johnpeck/boxcom/implement/boards/usb/reva/layout/printable/prettypic.png

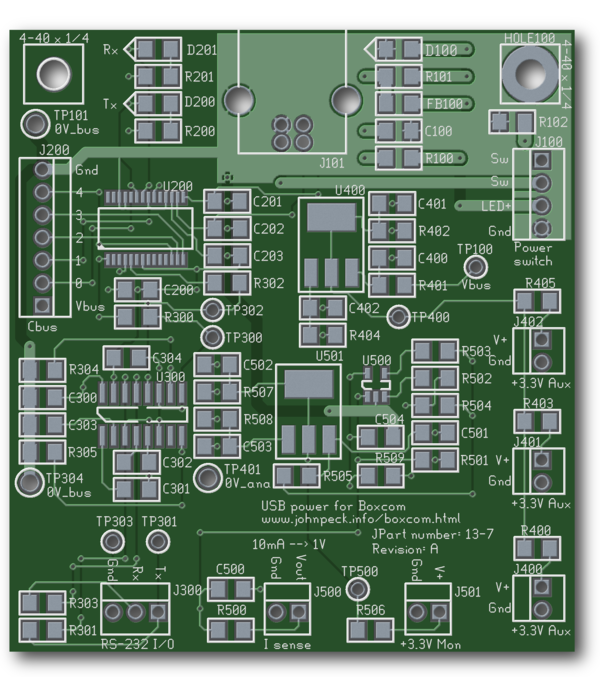
implement/boards/usb/reva/layout/printable/prettypic.png
