johnpeck/boxcom/README

Boxcom -- ASCII communication for the AVR Butterfly
