johnpeck/boxcom/implement/chassis/revb/sticker/output/sticker.pdf

# Boxcom

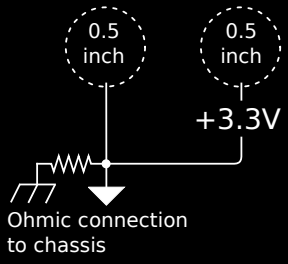
[picture p2: figure]
0.5 inch; Ohmic connection to chassis
