johnpeck/boxcom/implement/simulations/lt3080_sensing.pdf

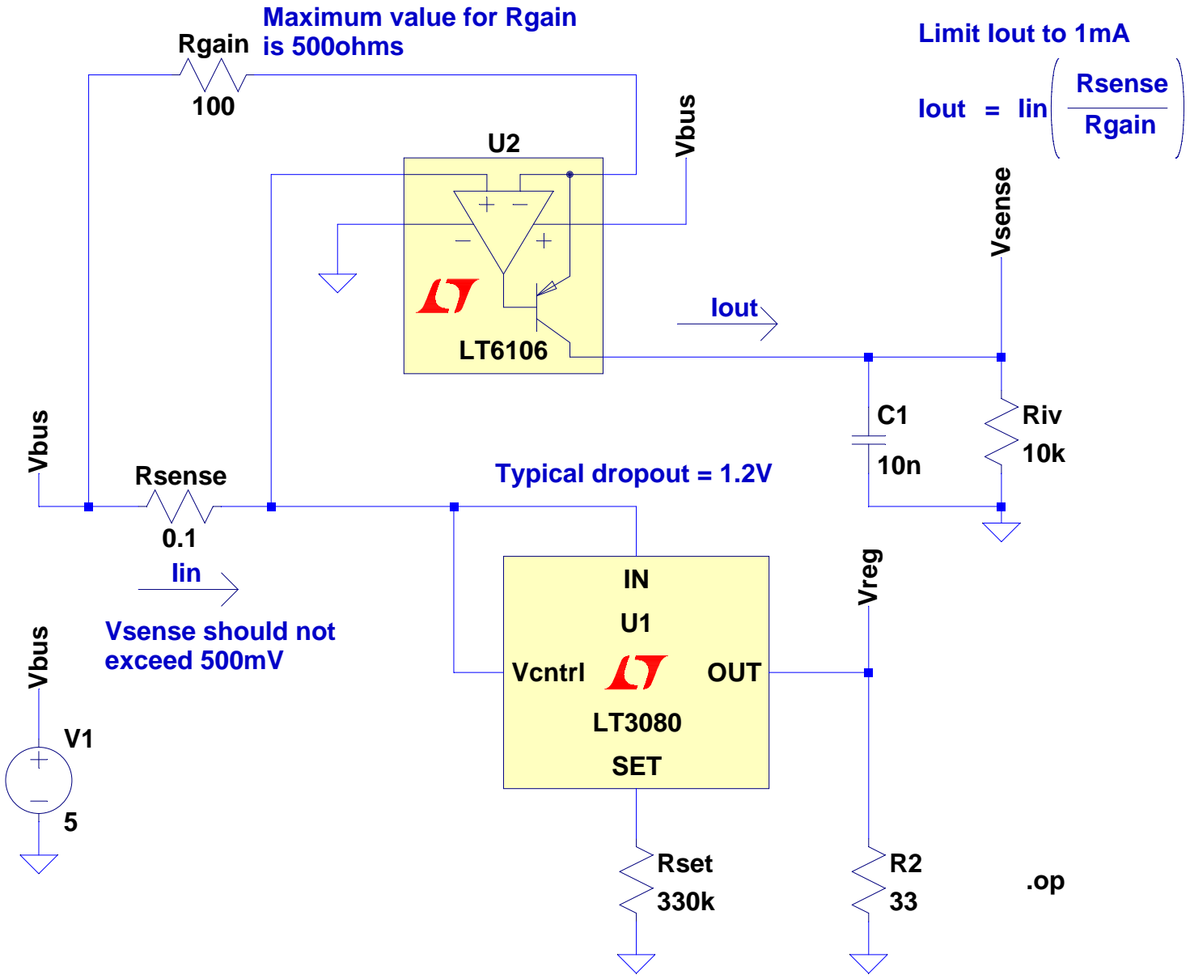
[picture p3: figure]
SET; Vcntrl; OUT; Rset 330k; Rsense; Rgain; Riv 10k; C1 10n Vreg; Vsense; Vbus Vbus; Vbus; Iin; Iout; Rsense Rgain =; Maximum value for Rgain; is 500ohms; Limit Iout to 1mA; Typical dropout = 1.2V; Vsense should not exceed 500mV

uments and Settings\jpeck.THINKSRS\My Documents\projects\boxcom\implement\simulations\lt3080_sensi
