johnpeck/boxcom/implement/howto/commands/idn.tex

\asciicmd{*IDN?}{
    \index{user_cmds_index}{*IDN?}
    \label{cmd:idn}

    \textbf{Name:} \texttt{*IDN?} -- Print the instrument identification string.\\
    \textbf{Description:} No description.
}
