johnpeck/boxcom/implement/howto/commands/curslp.tex

\asciicmd{\$curslp\{i\}}{
    \index{internal_cmds_index}{\$curslp}
    \label{cmd:curslp}

    \textbf{Name:} \texttt{\$curslp} -- Set the current output slope calibration 
                                        factor.\\
    \textbf{Description:} No description.

}
