johnpeck/boxcom/implement/howto/howto.pdf

## boxcom howto

May 11, 2013

## Contents

1 USB board | 3
2 Butterfly board | 7
3 Firmware | 8
Alphabetical command index | 15
Internal command index | 16

2

### 1 USB board

## 1 USB board

### 1.1 The front panel switch

Figure 1 shows how the front panel power switch should be wired.

+ -

Switch

Switch

LED+

LED-

Eswitch panel
rocker switch
Part 21-1

5-inch lengths
of 24-gauge wire

Cover each solder
lug with 1/2-inch
of 1/8-inch heat
shrink (16-22)

Bind wires together
with two 1/4-inch pieces
of 1/8-inch heat shrink
(16-22)

Figure 1: Panel switch wiring

Boxcom howto | 3 | May 11, 2013

1 USB board | 1.2 Board checkout

### 1.2 Board checkout

### 1.2.1 Voltage rails

Use table 1 to keep track of voltage rails.

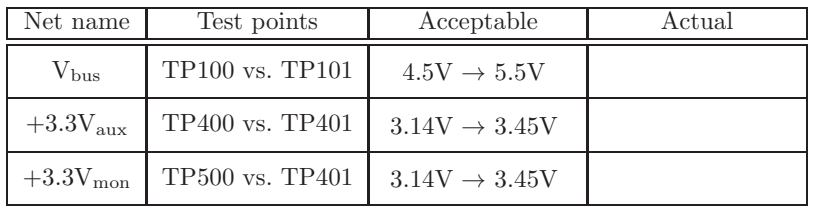
[picture p4: figure]
Net name; Test points; Acceptable; Actual; Vbus; +3.3Vaux; +3.3Vmon

Table 1: Voltage rail checkout table for the USB board.

### 1.2.2 Current monitor

The current monitor output at J500 will have a fixed DC output, since the voltage regulator following it always draws at least 1mA. As illustrated in figure 2, the slope set in hardware should give ∆Vout = 1V for each additional 10mA of current draw from J501. Since the voltage output from J501 is controlled at 3.3V, a test load of 3.3kΩ should increase the voltage at J500 by 100mV.

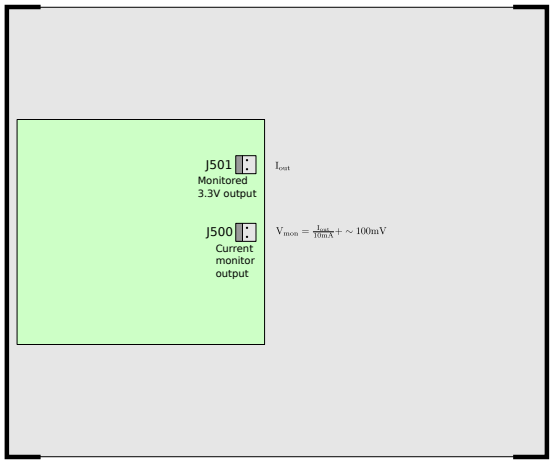
[picture p5: figure]
Current monitor output; Monitored 3.3V output

Figure 2: The output connectors used during the current monitor test.

Load applied to J501 | Acceptable Vout at J500 | Measured Vout at J500

Table 2: Passing voltage measurements for the current monitor test.

Boxcom howto | 4 | May 11, 2013

1 USB board | 1.2 Board checkout

### 1.2.3 Serial loopback

The serial loopback test is a basic test of the USB/serial interface and the RS-232 transceiver. Make the breakout cable shown in figure 3, then make connections to the board as shown in figure 4.

1 2 3 4 5

6 7 8 9

Chassis-mount DB-9
connector
Part number 14-16

3-pin mta100 plug
Part number 14-10

Use 24AWG stranded
wire for mta100

Figure 3: Wiring the DB9 breakout cable for the serial loopback test.

The serial loopback test script is:

boxcom/implement/data/scripts/tty loopback.py

...and the test should pass at the speed listed in table 3.

Minimum passing baud | Measured passing baud

Table 3: Passing baud measurement for the serial loopback test. The usb board should be able to reliably pass the loopback test for data flowing in both directions at the minimum baud.

Boxcom howto | 5 | May 11, 2013

1 USB board | 1.2 Board checkout

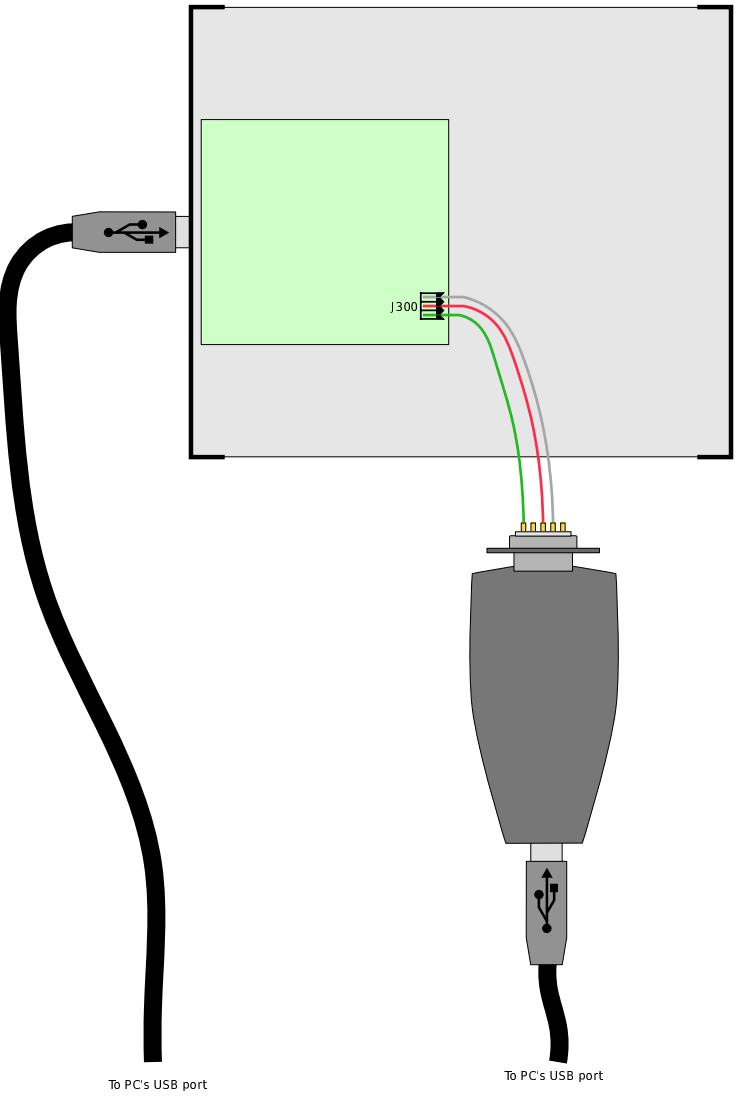
[picture p6: figure]

Figure 4: The setup for the serial loopback test.

Boxcom howto | 6 | May 11, 2013

### 2 Butterfly board

## 2 Butterfly board

### 2.1 Making connections

Figure 5 shows the connections that should be made to the Butterfly board.

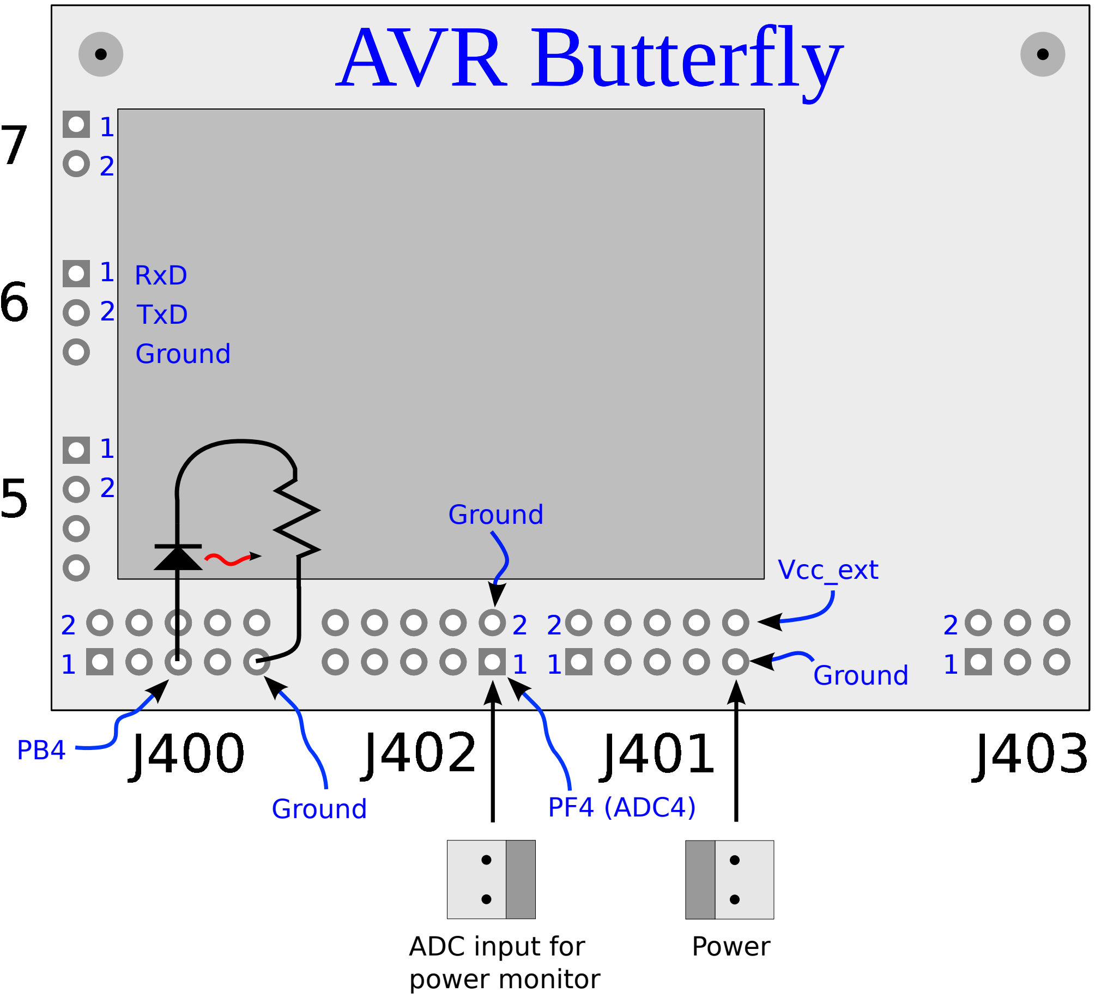
[picture p7: figure]
AVR Butterfly; ADC input for power monitor; Ground; PF4 (ADC4); Power; Vcc_ext; RxD TxD Ground

Figure 5: Connections to the AVR Butterfly

Figure 6 shows how the UART cable should be made.

6 inches

es
h h
shrin

(This side shown

ed

Figure 6: The UART cable connecting the Butterfly and USB boards.

Figure 7 shows how to make the power cable.

6 inches

es
h h
shrin

(This side shown

ed

Figure 7: The power cable connecting the Butterfly and the USB boards. The cable should run from J400 on the USB board to the power connector shown in figure 5.

Boxcom howto | 7 | May 11, 2013

### 3 Firmware

## 3 Firmware

### 3.1 Received character flow

Receiving remote commands begins with receiving characters. Reception of these characters triggers an interrupt service routine (ISR), which handles them according to the flow shown in figure 8. The first step in this flow is loading the characters into the receive buffer.

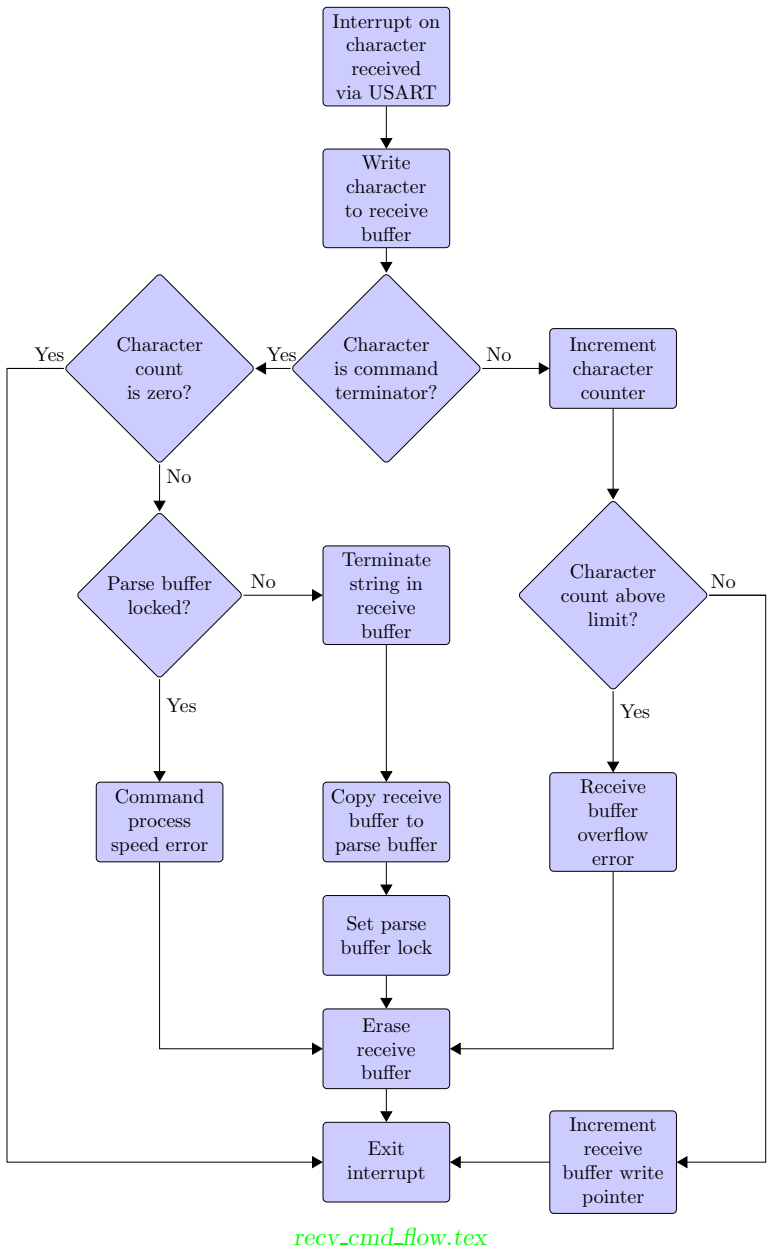
[picture p8: figure]
Interrupt on character received via USART; Write character to receive buffer; Character is command terminator?; Character count is zero?; Increment character counter; Parse buffer locked?; Terminate string in receive buffer; Copy receive buffer to parse buffer; Set parse buffer lock; Erase receive buffer; Character count above limit?; Receive buffer overflow error; Command process speed error; Exit interrupt; Increment receive buffer write pointer; Yes; recv cmd flow.tex

Figure 8: Program flow for processing characters received over the Butterfly’s USART. Sending a command terminator (carriage return) will always result in an empty receive buffer. This is a good way to make sure there’s no garbage in the buffer before writing to it.

Boxcom howto | 8 | May 11, 2013

3 Firmware | 3.1 Received character flow

Figure 9 illustrates the receive buffer loaded with a combined string. The buffer is accessed with a pointer to its beginning and a second pointing to the next index to be written. These pointers are members of the recv cmd state t type variable recv cmd state. This is just style – I like to try to organize variables used in a flow by making them members of their own structure. Naming conventions aside, it’s important to notice that there are no limitations on command or argument size imposed in this first step, provided that the total character count stays under the RECEIVE BUFFER SIZE limit.

## RECEIVE_BUFFER_SIZE

Buffer size set with #define

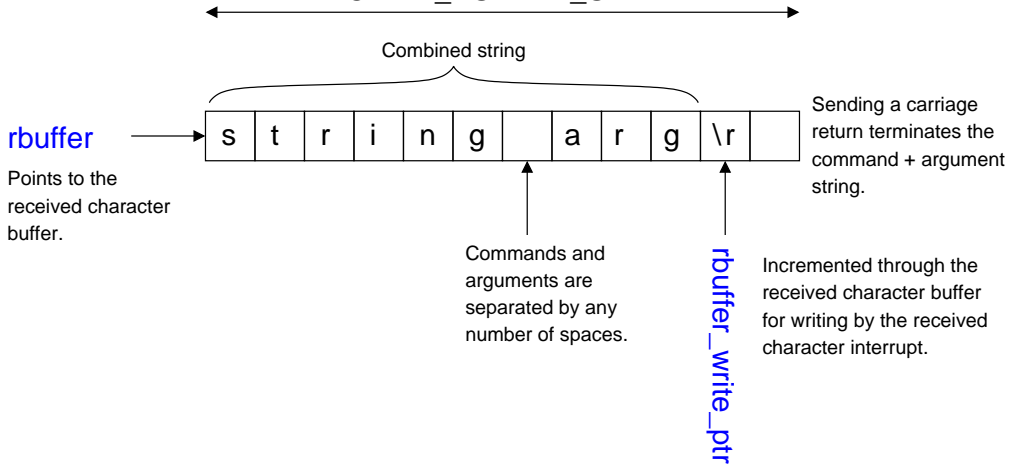
[picture p9: figure]
Commands and arguments are separated by any number of spaces.; Incremented through the received character buffer for writing by the received character interrupt.; Sending a carriage return terminates the command + argument string.; Points to the received character buffer.; rbuffer; rbuffer_write_ptr; Combined string

recbuffer.fig

Figure 9: The received character buffer and pointers used to fill it. There is no limit to the size of commands and their arguments, as long as the entire combined string and terminator fit inside RECEIVE BUFFER SIZE.

When a combined string in the receive buffer is finished with a carriage return, the string is copied over to a second buffer. I call this the parse buffer, since this is where the string will be searched for recognized commands and arguments. This buffer is locked until its contents can be processed to keep it from being clobbered by new combined strings. Sending commands faster than they can be processed will generate an error, and combined strings sent to a locked parse buffer will be dropped. The maximum command processing frequency will depend on the system clock and other system tasks. Not having larger parse or receive buffers is a limitation that puts this project at the hobby level. Extending these buffers to hold more than just one command would make the system more robust.

Boxcom howto | 9 | May 11, 2013

3 Firmware | 3.2 How remote commands are processed

### 3.2 How remote commands are processed

After combined strings are copied from the receive to the parse buffer, the system separates them into command and argument strings using the flow shown in figure 10. Commands in the parse buffer are then separated from their arguments with a string terminator inserted into the first space between the two. As illustrated in figure 11, pointers to the beginning of the parse buffer and the beginning of the argument will then reference two separate strings. The first of these two, the command string, is converted to lowercase and compared with those in the command definition array to look for a match.

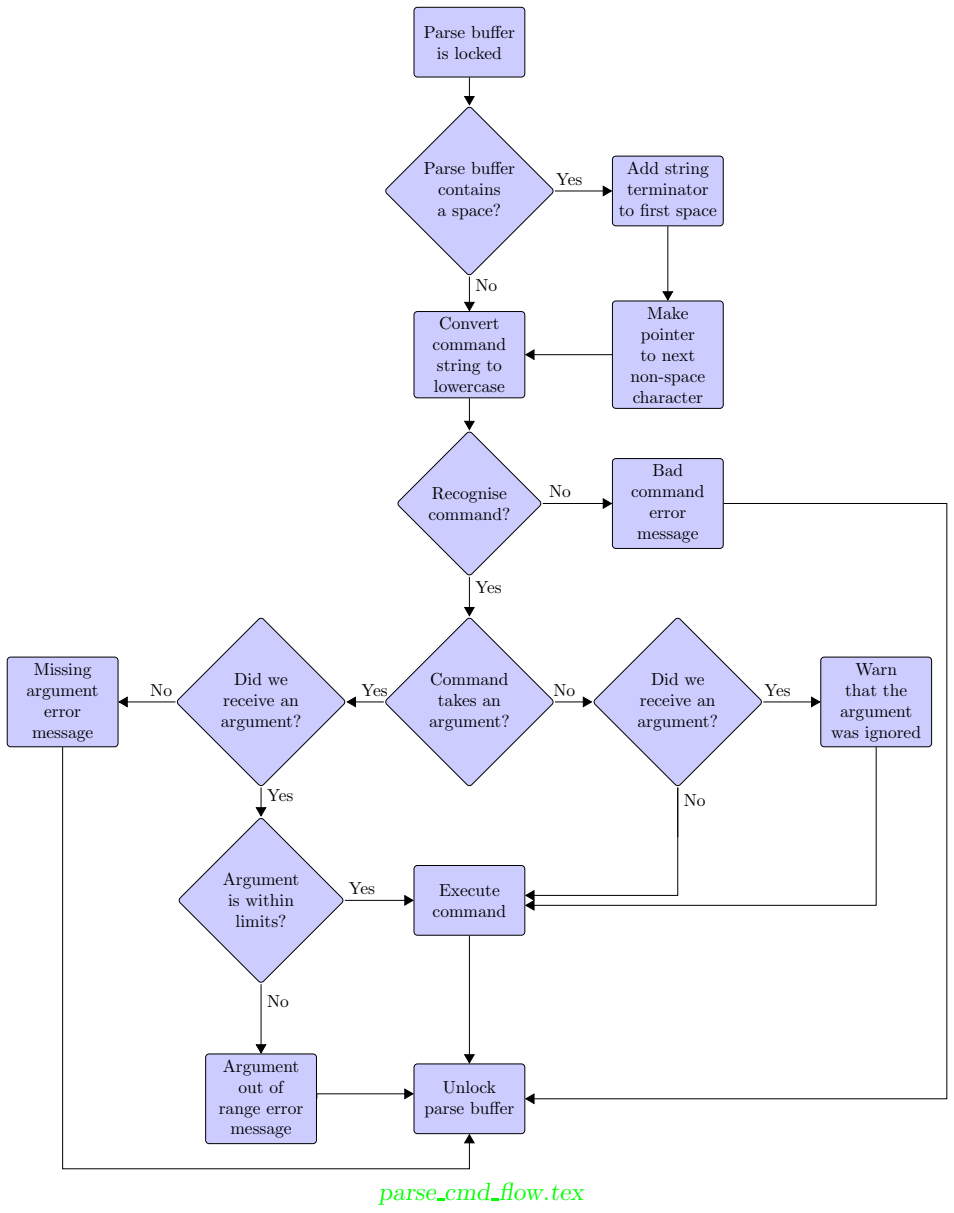
[picture p10: figure]
Parse buffer is locked; Parse buffer contains a space?; Add string terminator to first space; Convert command string to lowercase; Make pointer to next non-space character; Recognise command?; Bad command error message; Command takes an argument?; Did we receive an argument?; Warn that the argument was ignored; Missing argument error message; Argument is within limits?; Argument out of range error message; Execute command; Unlock parse buffer; Yes; parse cmd flow.tex

Figure 10: Program flow for processing fully-formed commands. This processing step happens in the main loop, so it will only run when the system isn’t busy doing something else. Notice that all incoming commands are converted to lowercase, so there’s no case sensitivity.

Boxcom howto | 10 | May 11, 2013

3 Firmware | 3.2 How remote commands are processed

### RECEIVE_BUFFER_SIZE

Same size as received character buffer

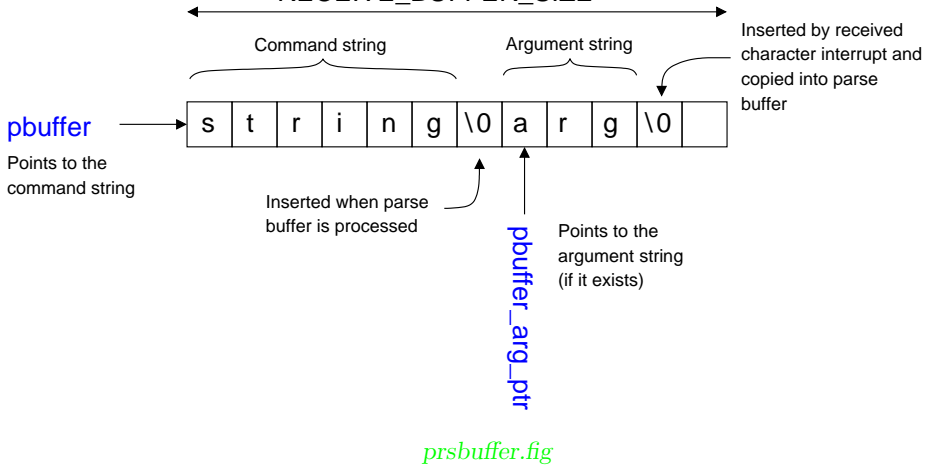
[picture p11: figure]
Points to the command string; Points to the argument string (if it exists); Inserted when parse buffer is processed; character interrupt and copied into parse buffer; Inserted by received; r pbuffer_arg_ptr; pbuffer; Command string; Argument string; prsbuffer.fig

Figure 11: The parse buffer with pointers to the command and argument strings. The single combined string copied from the receive buffer is made into two strings by inserting a string terminator.

Boxcom howto | 11 | May 11, 2013

3 Firmware | 3.3 Adding a new remote command

### 3.3 Adding a new remote command

1 – Choose a name for the command The command characters, the argument characters, one space, and one string terminator must all fit in the received command buffer. The definition of this size is shown below.

2 – Think about the command’s arguments The code can only handle unsigned hexadecimal number arguments formatted as strings. If you need something else, you’ll have to write more code.

3 – Add a function for your command to call I like to put the new function in the module where it belongs, and just add a “cmd ” prefix to it. If the command is a query, I add a “ q” suffix. The command corresponding to the vcounts? query is shown below.

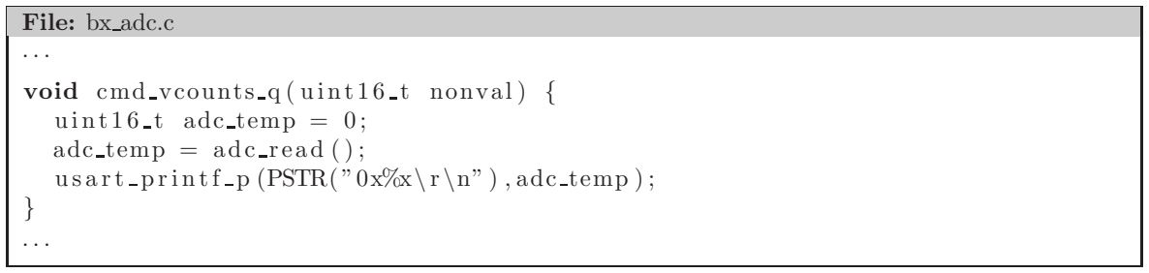
[picture p12: figure]
File: bx adc.c · · ·; u i n t 1 6 t adc temp = 0 ; adc temp = a d c r e a d ( ) ;

void cmd vcounts q ( u i n t 1 6 t nonval ) {

u s a r t p r i n t f p (PSTR( ” 0x%x\ r \n” ) , adc temp ) ;

4 – Give the new command an entry in the command array A sample entry in the command array is shown below. New entries must be added before the “end of table indicator.” Remember that hexadecimal arguments larger than 4 characters don’t make sense for 16-bit integers (leading 0x characters are not allowed).

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

3 Firmware | 3.4 Logger functions

### 3.4 Logger functions

### 3.4.1 logger msg p

void logger_msg_p( char *logsys, logger_level_t loglevel, const char *logmsg, ... );

Send a message to the logger module from permanent memory

Parameters

- logsys
Pointer to a string matching one of the logger system strings.
- loglevel
One of the logger level identifiers:

log_level_ISR (lowest level)

log_level_INFO

log_level_WARNING
log_level_ERROR (highest level)
- logmsg
Pointer to a string stored in permanent (flash) memory. This might be a C format string.
- ... (additional arguments)
Depending on the format string, the function may expect a sequence of additional arguments, each containing a value to be used to replace a format specifier in the format string. There should be at least as many of these arguments as the number of values specified in the format specifiers. Additional arguments are ignored by the function.

Examples

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

Output (After receiving the hello command):

[I](command) Command ’hello’ recognized.

Boxcom howto | 13 | May 11, 2013

3 Firmware | 3.5 Calibration factors

### 3.5 Calibration factors

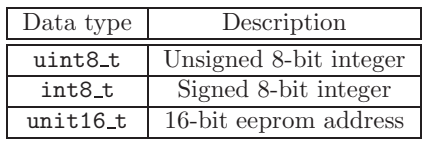
[picture p13: figure]
Data type; Description; uint8 t; Unsigned 8-bit integer; int8 t; Signed 8-bit integer; unit16 t; 16-bit eeprom address

Table 4: The calibration factor structure will consist of two 8-bit integers and a base address for the calibration factor in eeprom memory. The eeprom memory locations will need to be two addresses apart.

Boxcom howto | 14 | May 11, 2013

3 Firmware | 3.5 Calibration factors

## Alphabetical command index

Boxcom howto | 15 | May 11, 2013

3 Firmware | 3.5 Calibration factors

## Internal command index

Boxcom howto | 16 | May 11, 2013
