johnpeck/boxcom/implement/howto/internal_commands.tex

\section{Internal commands}

% $curslp
\input{commands/curslp}
\hdivline{}

% $setser
\input{commands/setser}
\hdivline{}
