johnpeck/boxcom/implement/howto/user_commands.tex

\section{Remote commands}

% *IDN?
\input{commands/idn}
\hdivline

% logreg
\input{commands/logreg}
\hdivline{}

% loglev
\input{commands/loglev}
\hdivline{}

%curout?
\input{commands/curout}
\hdivline

%curper
\input{commands/curper}
\hdivline
