johnpeck/boxcom/implement/boards/usb/reva/schematics/printable/usb_board.pdf

FILE: | | REVISION:
PAGE | OF | DRAWN BY:

TITLE A

1 | 2 | 3 | 4 | 5
E | E
D | D
C | C
B | B

F

6 | 7 | 8 | 9

A

F

1 | 2 | 3 | 4 | 5 | 6 | 7 | 8 | 9

# Contents

0 | 6

# Boxcom USB interface board

# 1. USB input 2. USB I/O

# 4. Auxiliary 3.3V power outputs 5. Current monitor

contents.sch
John Peck

A

# 3. RS−232 I/O

# 6. Other hardware

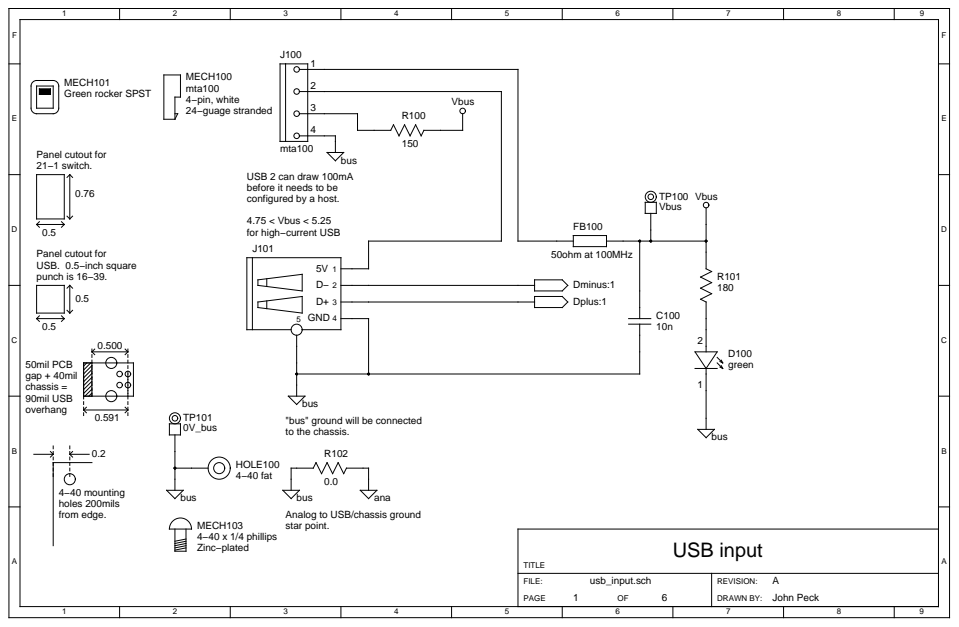
[picture p14: page 2]

USB 2 can draw 100mA
before it needs to be
configured by a host.
4.75 < Vbus < 5.25
for high−current USB

bus
"bus" ground will be connected
to the chassis.

Analog to USB/chassis ground
star point.

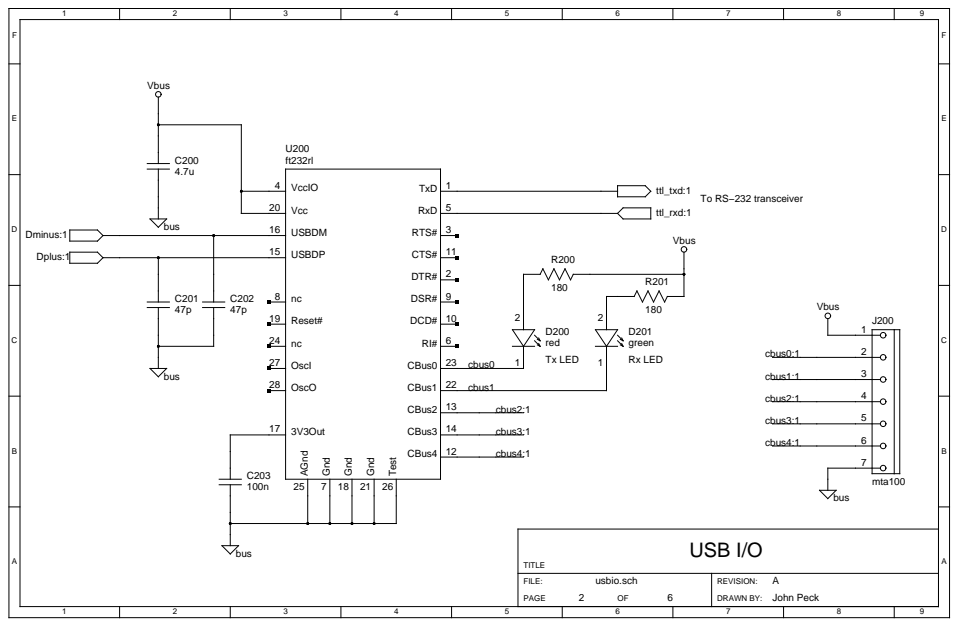
[picture p15: page 3]

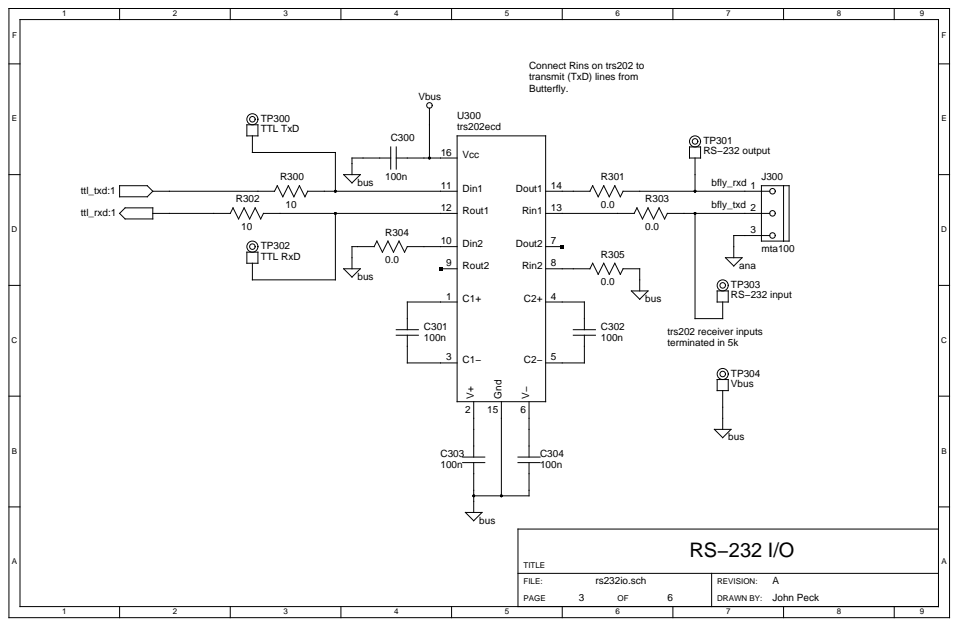
[picture p16: page 4]

Connect Rins on trs202 to
transmit (TxD) lines from
Butterfly.

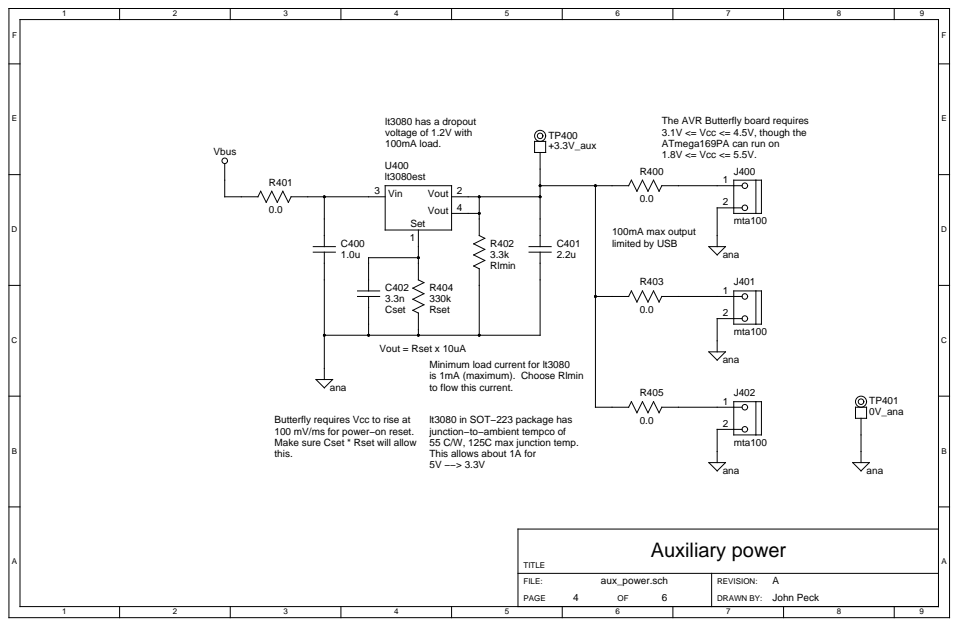
[picture p17: page 5]

The AVR Butterfly board requires
3.1V <= Vcc <= 4.5V, though the
ATmega169PA can run on
1.8V <= Vcc <= 5.5V.

Minimum load current for lt3080
is 1mA (maximum). Choose Rlmin
to flow this current.

100 mV/ms for power−on reset.
Make sure Cset * Rset will allow
this.

lt3080 in SOT−223 package has
junction−to−ambient tempco of
55 C/W, 125C max junction temp.
This allows about 1A for

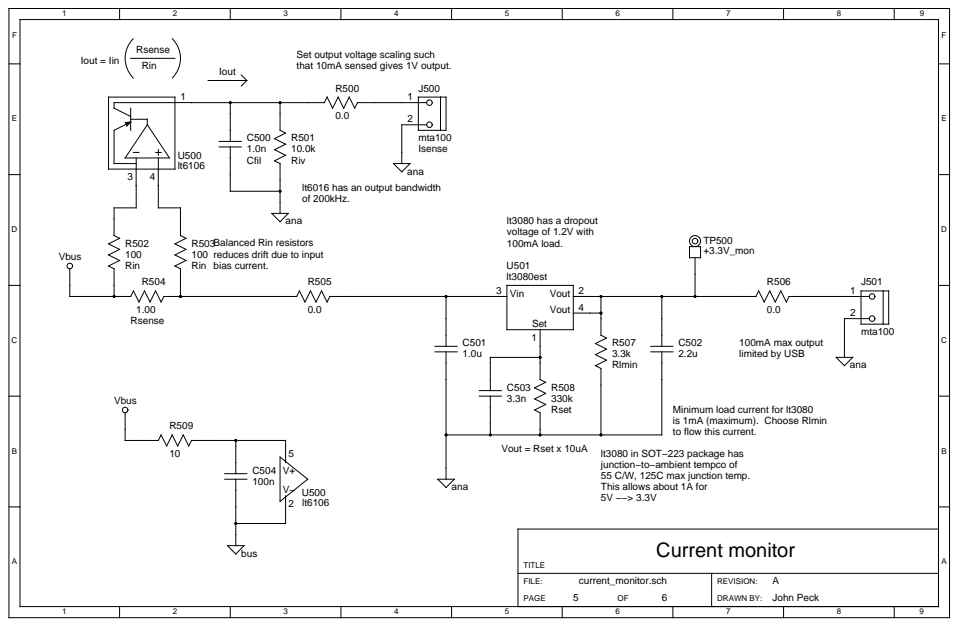
[picture p18: page 6]

Set output voltage scaling such
that 10mA sensed gives 1V output.

lt6016 has an output bandwidth
of 200kHz.
ana

Minimum load current for lt3080
is 1mA (maximum). Choose Rlmin
to flow this current.

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

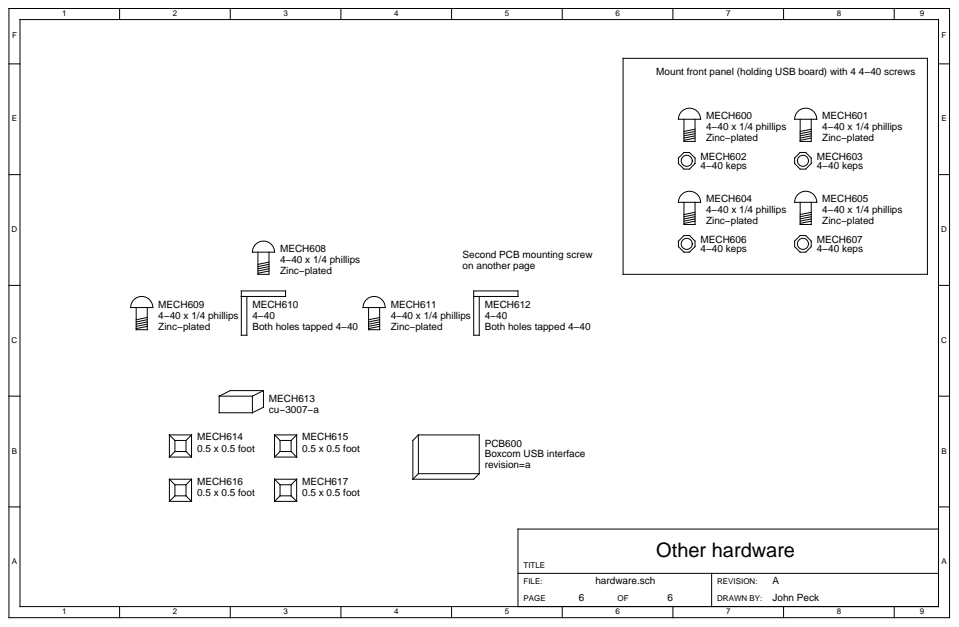
[picture p19: page 7]
FILE:; REVISION:; PAGE; DRAWN BY:; TITLE A; Other hardware; hardware.sch; John Peck; MECH610; Both holes tapped 4−40; MECH614 0.5 x 0.5 foot; MECH615 0.5 x 0.5 foot; MECH616 0.5 x 0.5 foot; MECH617 0.5 x 0.5 foot; MECH612; MECH613; 4−40 x 1/4 phillips; MECH608; Zinc−plated; MECH609; MECH611; Boxcom USB interface; PCB600; revision=a; MECH600; MECH601; MECH604; MECH605; 4−40 keps; MECH606; MECH607; MECH602; MECH603

Mount front panel (holding USB board) with 4 4−40 screws

Second PCB mounting screw
on another page
