johnpeck/boxcom/implement/simulations/lt3080_sensing.asc

C1: cap; 10n
R2: res; 33
Rgain: res; 100
Riv: res; 10k
Rsense: res; 0.1
Rset: res; 330k
U1: LT3080
U2: LT6106
V1: voltage; 5
Named nets: 0, Vreg, Vsense, Vbus
.op
Iin
Iout
Iout
Iin
Rsense
Rgain
=
Maximum value for Rgain
is 500ohms
Limit Iout to 1mA
Typical dropout = 1.2V
Vsense should not
exceed 500mV
