johnpeck/boxcom/(list of files, drawings)

Other design files:
implement/boards/usb/reva/layout/usb_board.pcb
