johnpeck/boxcom/implement/boards/butterfly/code/bx_sound.c

/* bx_sound.c

   Sound module for boxcom

   The piezo noisemaker on the Butterfly board is connected to PB5,
   which is also OC1A.  So it's natural to use timer1 to do waveform
   generation for making sound.
*/

// ----------------------- Include files ------------------------------
#include <stdio.h>

/* avr/io.h
   
   Device-specific port definitions
*/
#include <avr/io.h>

/* bx_rtc.h

   Provides functions for working with the real time clock.
*/
#include "bx_rtc.h"

/* bx_logger.h

   Provides logger_msg and logger_msg_p for log messages tagged with a
   system and severity.
*/
#include "bx_logger.h"

/* pgmspace.h
  
   Contains macros and functions for saving and reading data out of
   flash.
*/
#include <avr/pgmspace.h>

#include "bx_sound.h"

// ----------------------- Canned music -------------------------------

/* Each canned music array must end with a zero! */

const uint16_t sndramp[] PROGMEM = {100, 110, 120, 130, 140, 150, 
				    160, 170, 180, 190, 200, 0};

const uint16_t boot_sound[] PROGMEM = {200, 250, 300, 0};

const uint16_t warn_sound[] PROGMEM = {200, 1, 200, 0};

const uint16_t error_sound[] PROGMEM = {300, 200, 0};


// ----------------------- Functions ----------------------------------




/* sound_init()

   Configures timer1 to be clocked by the system clock divided down to
   1MHz.  Sets Clear Timer on Compare match (CTC) mode to make square
   waves with OC1A.  Sets the OCR1A value, but leaves the data
   direction of OC1A set to input (DDB5 bit in the DDRB register set
   to 0).  When playing a tone, set a new OC1A value, then change the
   port data direction.
*/
void sound_init(void) {
  logger_msg_p("sound",log_level_INFO,
	       PSTR("Initializing sound\r\n"));
  /* Set TCCR1B (timer/counter control register B) value

     Set the clock source to internal, fosc/8 (for fosc=8MHz)
     Set CTC mode
   */
  TCCR1B &= ~(_BV(CS12) | _BV(CS10));
  TCCR1B |= _BV(CS11);
  TCCR1B &= ~_BV(WGM13);
  TCCR1B |= _BV(WGM12);

  /* Set TCCR1A (timer/counter control register A) value

     Toggle OC1A on compare match
     Set CTC mode
   */
  TCCR1A &= ~_BV(COM1A1);
  TCCR1A |= _BV(COM1A0);
  TCCR1A &= ~(_BV(WGM11) | _BV(WGM10));

  /* Set initial value for OCR1A (16-bit value) */
  OCR1AH = 0;
  OCR1AL = 0;
  
}


/* sound_counter_stop()

   Stops the counter used for the sound module (timer1).  Does not
   reset it.
*/
void sound_counter_stop(void) {
  // Set all CS values to 0 to remove clock source -- stoping counter
  TCCR1B &= ~(_BV(CS12) | _BV(CS11) | _BV(CS10));
}

/* sound_counter_start()

   Starts the counter used for the sound module (timer1).  Configures
   prescaler for a 1MHz clock.
*/
void sound_counter_start(void) {
  TCCR1B &= ~(_BV(CS12) | _BV(CS10));
  TCCR1B |= _BV(CS11);
}

/* sound_counter_zero()
   
   Clears the counter used for the sound module (timer1).  Also clears
   the output compare flag OCF1A.
 */
void sound_counter_zero(void) {
  TCNT1H = 0;
  TCNT1L = 0;
  /* The timer1 output compare flag is cleared by writing a 1 to
     it. */
  TIFR1 &= _BV(OCF1A);
}


/* sound_play_timed( frequency (Hz), duration (ms))

   Play a tone for the specified amount of time.  Timer1 is clocked at
   1MHz, so the maximum frequency is 1MHz/2 = 500kHz.  The minimum frequency is
   1MHz/(2 * 65536) = 7.6Hz.

   fout = 1MHz / (2 * (1 + OCR1A)) so
   OCR1A = 1MHz / (2 * fout) - 1
 */
void sound_play_timed( uint16_t frequency, uint16_t duration_ms ) {
  /* Use the old_, new_, and all_ms variables to take care of pretty
     good timing.
   */
  const uint16_t minfreq = 10; // Hz -- minimum possible freq
  const uint16_t maxfreq = 20000; // Hz -- maximum possible freq
  sound_counter_stop();
  sound_counter_zero();
  DDRB |= _BV(DDB5); // Make PB5 (OCR1A) an output
  /* The sound is generated by the output compare pin (OCR1A)
     toggling.  It changes state when the sound counter (timer1)
     reaches the compare value (OCR1A).  Calculating the compare
     value here is expensive, but not a big deal. */
  uint16_t compval = 0; // Will be the output compare value
  if ( (frequency >= minfreq) & (frequency <= maxfreq) ){
    compval = (uint16_t) (1e6 / (2 * frequency) + 0.5) - 1;
  }
  else {
    compval = 0xffff;
  }
  logger_msg_p("sound",log_level_INFO,
	       PSTR("Compare value is %i\r\n"),compval);
  OCR1AH = (uint8_t)(compval >> 8);
  OCR1AL = (uint8_t)(compval & 0xff);
  sound_counter_start();

  
  // Busy loop for the specified duration
  uint16_t retval = ms_delay( duration_ms );
  sound_counter_stop(); // Stop the sound
  logger_msg_p("sound",log_level_INFO,
	       PSTR("Played for %i ms\r\n"),retval);
}

/* sound_play_array_p( array of frequency data) 

   Accepts a pointer to an array of 16-bit numbers located in flash
   memory.  Each number is a frequency in Hz, and each frequency will
   be played for 100ms.  To play a tone for 200ms, give the tone two
   entries.
*/
void sound_play_array_p( const uint16_t *data_ptr ) {
  uint16_t snd_data = 1; // Dummy initialization values
  snd_data = pgm_read_word(&(*data_ptr));
  while ( (snd_data != 0) ) {
    sound_play_timed((uint16_t)(snd_data),100);
    data_ptr++;
    snd_data = pgm_read_word(&(*data_ptr));
  }
} 

/* sound_play_startup()

   Play a sound after everything has initialized and we're starting
   the main loop. 
*/
void sound_play_startup(void) {
  sound_play_array_p( boot_sound );
}

/* sound_play_warn()

   Play a warning sound.
*/
void sound_play_warn(void) {
  sound_play_array_p( warn_sound );
}

/* sound_play_error()

   Play an error sound.
*/
void sound_play_error(void) {
  sound_play_array_p( error_sound );
}

     
