johnpeck/boxcom/implement/boards/butterfly/code/bx_adc.c

/* bx_adc.c
   Used to set up the ADC for the boxcom project. 
*/

/* bx_usart.h 

   Provides functions for transmitting characters over the
   usart.
*/
#include "bx_usart.h"

/* pgmspace.h
   
   Provides macros and functions for saving and reading data out of
   flash.
*/
#include <avr/pgmspace.h>

/* stdint.h
  
   Defines fixed-width integer types like uint8_t
*/
#include <stdint.h>

/* avr/io.h
   
   Device-specific port definitions
*/
#include <avr/io.h>

/* bx_logger.h

   Provides logger_msg and logger_msg_p for log messages tagged with a
   system and severity.
*/
#include "bx_logger.h"

#include "bx_adc.h"

/* The voltage measurement calibration factors
 */
adc_cal_t volt_calfactor = {
    1, // Slope (mV/count)
    0  // Offset (mV)
};
adc_cal_t *volt_calfactor_ptr = &volt_calfactor;



/* adc_init()
 
   Initialize the Butterfly's 10-bit SAR ADC module.
   Set the default ADC mux position to 1: the voltage reader
*/
void adc_init(void) {
  logger_msg_p("adc",log_level_INFO, PSTR("Initializing ADC\r\n"));
  /* Disable JTAG.  In order to prevent unintentional writes to this
     bit, I need to write to it twice within 4 cycles.
  */
  for(uint8_t count = 0; count < 2; count++) {
    MCUCR |= ( 1<<JTD );
  }
  if ( MCUCR & (1<<JTD))
    logger_msg_p("adc",log_level_INFO, PSTR("JTAG disabled\r\n"));

  /* The butterfly has Vcc connected to AVcc via a low-pass filter.
     It also has a shunt capacitor at the Aref pin.  So I can use the
     voltage at AVcc as the reference. 
  */
  ADMUX = (0<<REFS1) | (1<<REFS0);

  /* Right-justify the data in the high and low registers by clearing
     ADLAR.  This is a 10-bit ADC. 
  */
  ADMUX &= ~(_BV(ADLAR));

  /* The butterfly's voltage reader is connected to ADC1 on pin 60.
     This makes a nice initialization value. 
  */
  ADMUX |= 1;

  /* Enable the ADC and set the fosc --> fsar prescaler.
     
     The SAR conversion requires between 50 and 200kHz for 10-bit
     resolution, but can be set as high as fosc/2 for lower
     resolution.  

     With a 1MHz clock (fosc), set the prescaler to 8 to get fsar =
     125kHz.  Normal conversions take 13 cycles, or 13*8us = 104us for
     fsar = 125kHz.  The maximum conversion rate is thus fsar / 13 or
     9.6kHz for fsar = 125kHz.

     ADCSRA = (1<<ADEN) | (1<<ADPS1) | (1<<ADPS0); fsar = 125kHz

     With a 8MHz clock (fosc), set the prescaler to 64 to have the
     same conversion timing as for the 1MHz clock: 9.6ksamp/sec

     ADCSRA = (1<<ADEN) | (1<<ADPS2) | (1<<ADPS1) | (0<<ADPS0);
  */
  ADCSRA = (1<<ADEN) | (1<<ADPS2) | (1<<ADPS1) | (0<<ADPS0);

  /* Disable auto-triggering.  We'll trigger the ADC manually. */
  ADCSRA &= ~(_BV(ADATE));

  /* The first ADC conversion will take 25 ADC clock cycles instead of
     the normal 13.  The first one initializes the ADC. Take a single
     conversion for this initialization step. 
  */
  ADCSRA |= (1<<ADSC);

  /* The ADIF bit in the ADCSRA register will be set when the conversion
     is finished. Wait for conversion to finish. 
  */
  while(!(ADCSRA & (1<<ADIF)));
}

/* adc_mux(channel)

   Set the mux channel for the ADC input.
   channel = 0 -- ADC0
   channel = 1 -- ADC1 (Butterfly's voltage reader)
   ...
   channel = 7 -- ADC7
   
   The mux selection overrides any data direction selection made with
   DDRF.  See section 13.3 of the datasheet. (is this true?)
*/
void adc_mux(uint8_t channel) {
  ADMUX &= (1<<REFS1) | (1<<REFS0) | (1<<ADLAR);
  ADMUX |= channel;
  logger_msg_p("adc",log_level_INFO,
	       PSTR("Switched to ADC channel %i\r\n"),channel);
}

/* adc_read() 
   
   Return a measurement made with the ADC.
*/
uint16_t adc_read(void) {
  uint16_t adc_temp = 0;

  /* Enable the ADC.  It seems like I already did this in adc_init(),
     but the part locks up if I don't also do it here. 
  */
  ADCSRA |= _BV(ADEN);

  ADCSRA |= (1<<ADSC);  // Do a single conversion
  while(!(ADCSRA & (1<<ADIF)));  // Wait for the conversion to finish
  adc_temp = ADCL;            // Read the lower 8 bits
  adc_temp += (ADCH << 8);    // Add the upper 2 bits
  return adc_temp;
}

/* Function called by the remote command "adcval?" 
   
   Query the raw ADC counts.
*/
void cmd_adcval_q( command_arg_t *command_arg_ptr ) {
  uint16_t adc_temp = 0;
  adc_temp = adc_read();
  usart_printf_p(PSTR("0x%x\r\n"),adc_temp);
}
