johnpeck/boxcom/implement/boards/butterfly/code/bx_functions.c

/* bx_functions.c

   Miscellaneous system functions for the boxcom project 
*/




// ----------------------- Include files ------------------------------
#include <stdio.h>
#include <string.h>

/* pgmspace.h
 * Contains macros and functions for saving and reading data out of
 * flash.
 */
#include <avr/pgmspace.h>
#include "bx_usart.h"


/* bx_logger.h 

   Sets up logging 
*/
#include "bx_logger.h"

#include "bx_functions.h"


// ----------------------- Globals ------------------------------------

// idnstr format: Organization, model, serial, version
const char idnstr[] PROGMEM = "johnpeck,bx100,sn%u,0.0.1\r\n";

/* System status structure

   Keeps track of miscellaneous system status:
   -- Serial number
*/
system_state_t system_state;
system_state_t *system_state_ptr = &system_state;

// ----------------------- Functions ----------------------------------


/* functions_init()

   Calls cal_load_sernum(pointer to system status structure) to fill
   in the serial number.
*/
void functions_init(void) {
  cal_load_sernum(system_state_ptr);
}

/* cmd_idn_q( pointer to command argument structure )

   The function called by the "*IDN?" query
*/
void cmd_idn_q( command_arg_t *command_arg_ptr ) {
  usart_printf_p(idnstr,system_state_ptr -> sernum);
}

/* Function called by help

   Writes all the help strings to the remote interface.
*/
void cmd_help( command_arg_t *command_arg_ptr ) {
  print_help( command_array );
  return;
}

void print_help( command_t *command_array ) {
  while ((command_array -> execute) != 0) {
    usart_printf_p(command_array -> help);
    command_array++;
  }
  return;
}
