johnpeck/boxcom/implement/boards/butterfly/code/bx_ascii.c

/* bx_ascii.c
   
   Functions for handling ASCII characters. */

#include <ctype.h>  // Provides tolower()
#include "bx_ascii.h"

void lowstring(char *mixstring) {
    while (*mixstring != '\0') {
        *mixstring = tolower(*mixstring);
        mixstring++;
    }
}
