johnpeck/boxcom/(commit log)

2012-10-08 Added window grabbing script to make question post
    The script simply asks the user to click on a window,
    then it writes the window image to a png.
    [text.sch]
2012-10-08 Added hardware page
    [hardware.sch]
2012-10-12 Added datasheet for magnetic bead
2012-10-13 Fixed power supply turn-on ramp rate.
    [power.sch]
2012-10-15 Added usbio page.
    [power.sch, usbio.sch]
2012-10-17 Added schematic page for butterfly hardware.
    [contents.sch, hardware.sch]
2012-10-18 Added current sensing simulation.
2012-10-19 Added note about maximum output current.
    [power.sch]
2012-10-19 Added specifications for USB board.
2012-10-19 Added makefile for printing schematic pages.
2012-10-22 Added output filter to current monitor simulation.
    Also added pdf of simulation schematic.
2012-10-28 Added 4-40 mounting hole for grounding.
    [power.sch]
2012-10-31 Added todos for current monitor.
2012-11-01 Added more views to mechanical drawing.
    [hardware.sch]
2012-11-01 Added functional diagram.
    [usbio.sch]
2012-11-01 Created some schematic pages.
    Separated power.sch into aux_power.sch and monitored_power.sch.
    Added current_monitor.sch page.
    Added usb_input.sch page for the USB connector.
    [aux_power.sch, current_monitor.sch, hardware.sch, monitored_power.sch, power.sch, usb_input.sch, usbio.sch]
2012-11-02 Added current monitor part to current monitor schematic page.
    [current_monitor.sch]
2012-11-05 Added test points to 3-pin serial connector.
    [hardware.sch, usbio.sch]
2012-11-05 Split RS-232 transceiver to be on its own page.
    [rs232io.sch]
2012-11-06 Split pages.
    [usbio.sch]
2012-11-06 Added revision directory to schematics.
    [aux_power.sch, contents.sch, current_monitor.sch, hardware.sch, monitored_power.sch, rs232io.sch, text.sch, usb_input.sch]
2012-11-07 Committed usb_board.pdf usb board schematic printouts.
2012-11-07 Added panel cutouts to USB power entry page.
    [aux_power.sch, usb_input.sch]
2012-11-09 Added front panel rocker switch to USB power page.
    [usb_input.sch]
2012-11-09 Added binding posts to mechanical drawing.
    [contents.sch, hardware.sch, usb_input.sch]
2012-11-11 Added 4-pin header for switch to schematic.
    [usb_input.sch]
2012-11-12 Added green LED to usbio page.
    [usbio.sch]
2012-11-13 Added red transmit LED to usbio schematics.
    [usbio.sch]
2012-11-14 Added 7-pin header for cbus lines.
    [usbio.sch]
2012-11-14 Renumbered contents.
    [contents.sch]
2012-11-14 Added current sensing resistor.
    [current_monitor.sch]
2012-11-16 Added output current transducer to current monitor.
    [aux_power.sch, current_monitor.sch, hardware.sch, monitored_power.sch, rs232io.sch, usb_input.sch, usbio.sch]
2012-11-19 Added mounting details to schematics.
    [aux_power.sch, current_monitor.sch, hardware.sch, usb_input.sch]
2012-11-20 Renumbered all components.
    [aux_power.sch, current_monitor.sch, hardware.sch, rs232io.sch, usb_input.sch]
2012-11-21 Added pcb target to the makefile.
    [current_monitor.sch, hardware.sch]
2012-11-21 Fixed net problems for lt6106.
    [contents.sch, current_monitor.sch, usbio.sch]
2012-11-21 Added makefile for layout
    [usb_board.pcb]
2012-11-21 Edited layout makefile to include board technology parameters
    [usb_board.pcb]
2012-11-27 Worked on usb board layout.
    [usb_board.pcb]
2012-11-28 Positioned components around rs232 part.
    [contents.sch, rs232io.sch, usb_board.pcb]
2012-11-28 Placed parts from aux_power page
    [aux_power.sch, usb_board.pcb]
2012-11-30 Extended board dimensions.
    [current_monitor.sch, hardware.sch, usb_board.pcb]
2012-11-30 Junk commit
    [usb_board.pcb]
2012-11-30 Started positioning connectors.
    [usb_board.pcb]
2012-12-01 Added labels to usb board.
    [usb_board.pcb]
2012-12-03 Moved labels.
    [usb_board.pcb]
2012-12-03 Added power routing style
    [usb_board.pcb]
2012-12-04 Drew copper pour around USB connector.
    [usb_board.pcb]
2012-12-06 Routed ftdi part
    [usb_board.pcb]
2012-12-16 Routed power to RS-232 transceiver
    [usb_board.pcb]
2012-12-17 Small changes to pcb
    [usb_board.pcb]
2012-12-30 Routed current monitor
    [usb_board.pcb]
2012-12-31 Finished routing usb board
    [usb_board.pcb]
2013-01-29 Finished gerber export targets for submission
    [usb_board.pcb]
2013-01-31 Added note about schematic hosting
2013-02-01 Added ability to print silkscreen
    [usb_board.pcb]
2013-02-03 New cursor position
    [usb_board.pcb]
2013-02-03 Submitted rev A of USB board to Sierra
    [usb_board.pcb]
2013-02-05 Added the kit14 fill file
    [hardware.sch, usb_input.sch]
2013-02-07 Added path to gafrc
    [hardware.sch]
2013-02-12 Added blog outputs to makefiles
    [usb_board.pcb]
2013-02-16 Added usb board file to the howto
2013-02-19 Added panel switch wiring instructions
2013-02-23 Added the current monitor test to the howto
2013-03-01 Added modification directory for USB board
2013-03-12 Added binding posts to the butterfly board kit
    [hardware.sch]
2013-03-19 Added figure showing connections to butterfly
    [hardware.sch]
2013-03-19 Added uart cable drawing
2013-03-22 Added butterfly board section to howto
2013-03-25 Corrected UART cable drawing
2013-04-09 Added keps nut to hardware
    [hardware.sch]
2013-04-10 Added line to disable JTAG in ADC init
2013-04-13 Fixed bad connection drawing in the howto
    [bx_adc.c, bx_logger.c, bx_main.c]
2013-04-27 Added lock washer
    [hardware.sch]
2013-05-01 Added led module
2013-05-05 Added calibration module
2013-05-11 Added a bunch of cable drawings to the howto
2013-05-14 Added a command to set current output slope
2013-05-14 Added remote command to write current offset
2013-05-16 Main loop now writes to a measurement array
    The main loop now writes ADC measurements to
    an array of specified size. The idea is that
    this array will eventually be sent to the current
    module for averaging and calibration.
2013-05-17 Calibration values are now being applied in process current function
2013-05-20 Added usb board schematics to howto
2013-05-20 Implemented curper command
    Sets the current measurement period in milliseconds
2013-05-27 Made it easier to work on the sticker
    There's now a proof target to create a printable sticker to test
    on the chassis.
2013-05-28 Fixed const data type argument for help command
    [bx_command.c, bx_functions.c, bx_functions.h, bx_sound.c, bx_sound.h]
2013-05-28 Modified chassis sticker
2013-06-02 Switched to matplotlib for ui
2013-06-09 Modified current sample averaging to keep 2 extra bits
2013-06-11 Added section describing calibration to howto
2013-06-13 Fixed axis labels on hostapp
    [hostapp.py]
2013-06-14 Added a play icon to the stop button
2013-06-14 Added pause button to hostapp
2013-06-19 Added frame to contain radio buttons in hostapp
